Hrishikesh-Acharyya/Ultrasonic-Acoustic-Signal-Acquisition-and-Conditioning-Frontend/Analog_Frontend_Project_Report.pdf

# Ultrasonic Underwater Acoustic Signal Acquisition and Conditioning Frontend

### Comprehensive Design and Simulation Report

### Hrishikesh Acharyya

### February 2026

Abstract

This report details the theoretical design, mathematical modeling, and SPICE validation of an analog frontend engineered to acquire 45 kHz continuous-wave (CW) tone bursts from an Underwater Locator Beacon (ULB). The architecture implements a piezoelectric hydrophone model, a charge amplifier for signal conversion, an 8th-order Butterworth bandpass filter for rigorous out-of-band noise rejection, and an inverting buffer with a kickback filter for ADC interfacing. Transient and frequency response simulations confirm robust harmonic rejection and a highly linear phase response suitable for downstream Digital Signal Processing (DSP) and Time Difference of Arrival (TDOA) localization. Monte Carlo simulations quantify the worst-case error introduced by component tolerances to ensure manufacturing reliability.

## 1 Introduction

Acoustic localization of Underwater Locator Beacons (ULB) by Autonomous Underwater Vehicles (AUVs) requires highly resilient analog frontends capable of isolating specific frequency bands while rejecting severe mechanical noise from thrusters, environmental noise, vibrational noise, and electromagnetic interference (EMI) caused by ESC switching. This project presents a complete analog conditioning pipeline bridging a raw piezoelectric hydrophone output to an Analog-to-Digital Converter (ADC).
A ULB-362 beacon from RJE International was chosen as the reference. The beacons transmit an acoustic signal once every second after activation, converting a CMOS-level square wave into a sinusoidal pulse of duration > 9 ms. Detailed specifications can be derived from the device documentation [1].

## 2 Circuit Architecture

To ensure complete clarity, the entire frontend schematic is divided into three primary functional blocks to process the raw signal from the piezoelectric hydrophone without loss of fidelity.

### 2.1 Sensor Modeling and Charge Amplifier

Initial system parameters are derived from standard ULB and piezoelectric hydrophone specifications. Given an acoustic output of 160.5 dB re 1µPa at 1 meter [1], the acoustic pressure P in Pascals is:
P = 10

160.5
20 | × 10⁻⁶ ≈ 105.9 Pa | (1)

For the hydrophone, using a worst-case receiving sensitivity of −190 dB re 1V/µPa at 1 meter [2], the voltage sensitivity Sv is:

Sv = 10

−190
20 | ≈ 3.16 × 10⁻¹⁰ V/µPa | (2)

Consequently, the estimated unconditioned RMS voltage generated by the sensor at 1 meter is approximately 33.46 mVrms.
To prevent effects of variable cable capacitance, a charge amplifier topology is utilized. The charge amplifier converts accumulated piezoelectric charge directly into a proportional voltage, rendering the system’s gain mathematically independent of cable length. The sensor is modeled electrically as a voltage source in series with a capacitance Cp = 22 nF and a resistance Rp = 287 kΩ as per the topology laid out in [3]. The capacitance and resistance values were calculated by the method shown in [4].

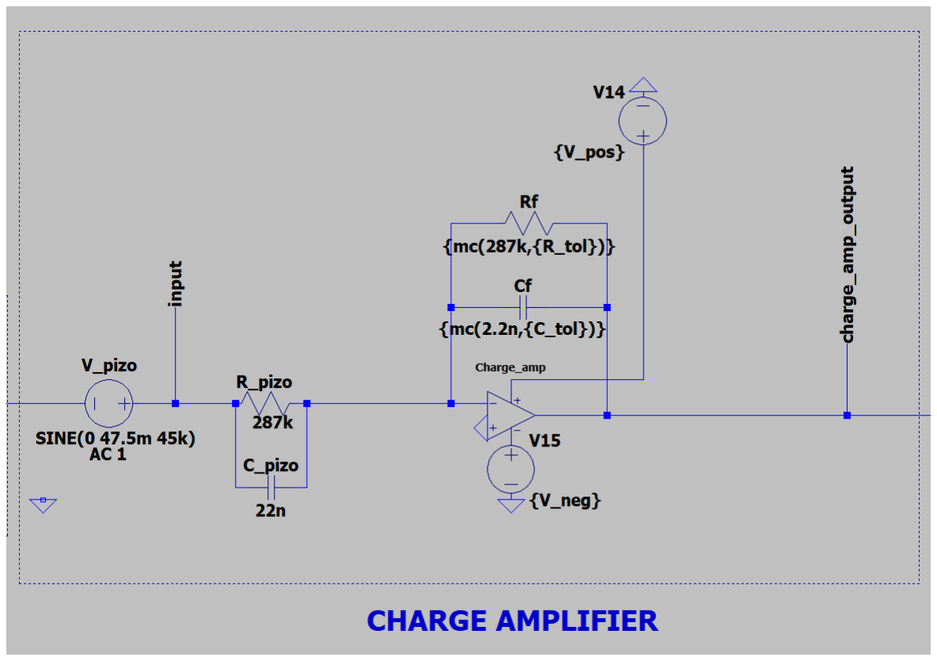
[picture p8: figure]

Figure 1: Stage 1: Hydrophone sensor model feeding into the Charge Amplifier.

The generalized transfer function of the inverting charge amplifier is:

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
1 + sRpCp
1 + sRfCf
(3)

where Zf is the feedback impedance and Zp is the source impedance.
From this complete transfer function, the specific passive component values (Rf and Cf ) are derived by analyzing the circuit at its frequency extremes:

### 1. DC Gain (s → 0): At DC, the capacitive reactance approaches infinity, and the

transfer function simplifies strictly to the ratio of the resistors:

Av(DC) = −

Rf
Rp

(4)

To prevent large DC offsets from saturating the operational amplifier, the DC gain must be restricted. The DC gain is set to unity (|Av| = 1, or 0 dB). Because the hydrophone’s internal resistance is Rp = 287 kΩ, the feedback resistor is explicitly chosen as Rf = 287 kΩ.

### 2. Midband Gain (s → ∞): At the ultrasonic frequencies of interest, s becomes

large, and the sRC terms dominate the numerator and denominator. The transfer function simplifies to the ratio of the capacitances:

Av(midband) ≈ −

Rf
Rp
sRpCp
sRfCf
= −

Cp
Cf

(5)

The sensor capacitance was found as Cp = 22 nF. To achieve a sufficient initial amplification of 20 dB (a voltage gain of 10 V/V) for the estimated 33.46 mVrms input signal, the feedback capacitor is strategically selected as:

Cf =

Cp
10

=

22 nF
10
= 2.2 nF | (6)

### 3. High-Pass Cutoff Frequency: The chosen feedback network (Rf = 287 kΩ, Cf =

2.2 nF) concurrently establishes the dominant pole of the charge amplifier, forming an intrinsic first-order high-pass filter. Care was taken to ensure the cutoff is not too high, otherwise it leaks into the overall filter passband:

fc =

1
2πRfCf

=

1
2π(287 kΩ)(2.2 nF) ≈ 252 Hz | (7)

### 4. High-Frequency Roll-Off and Non-Ideal Behavior: While the ideal transfer

function implies infinite bandwidth, the physical charge amplifier will exhibit an intrinsic low-pass roll-off at high frequencies. This behavior is not dictated by the primary feedback network, but rather by the finite Gain-Bandwidth Product (GBW) of the operational amplifier [3].
The high-frequency −3 dB cutoff of the charge amplifier is determined by the intersection of the op-amp’s open-loop gain roll-off and the circuit’s closed-loop noise gain

(Anoise):

Anoise ≈ 1 +

Cp
Cf

= 1 +

22 nF
2.2 nF
= 11 V/V | (8)

For an operational amplifier with a specified GBW, the intrinsic low-pass pole occurs at:

fLP F ≈

GBW

Anoise

(9)

Assuming a standard high-speed op-amp with a GBW of 100 MHz (as utilized in the SPICE models), the intrinsic low-pass roll-off begins at approximately 9.09 MHz. In the context of the analog frontend, this non-ideal characteristic is highly beneficial, as it acts as an anti-aliasing filter that suppresses extreme high-frequency EMI before the signal reaches the active 8th-order Butterworth stages.

### 2.2 8th-Order Butterworth Bandpass Filter

To achieve rigorous filtering and to isolate the 45 kHz CW tone, an 8th-order Butterworth bandpass filter was synthesized, establishing a passband from 35 kHz to 58 kHz. The architecture cascades two 2nd-order High-Pass Filters (HPF) [5] and two 2nd-order Low-Pass Filters (LPF) [6] utilizing Multiple Feedback (MFB) topologies [7].

### 2.2.1 Computational Synthesis of Filter Parameters

To ensure mathematical rigour, the derivation of the exact component values for the MFB cascaded network was performed using a custom Python computational script. Rather than calculating continuous theoretical values and rounding them—which often leads to severe center-frequency drift in high-Q stages—the algorithm operates by anchoring the math to discrete, commercially available E6 series capacitors.
The algorithm executes the following sequence to bridge the theoretical MFB transfer functions with physical hardware constraints:
1. E-Series Grid Search: The script iteratively sweeps through an array of standard E6 series capacitors (100 pF to 10 nF) to use as the foundational variables.
2. Gain and Topology Constraints: The script enforces a DC gain of -1 by setting C1 = C3 in HPF stages and R1 = R3 in LPF stages.
3. Mathematical Derivation: For the LPF, the script evaluates the discriminant (b

2 − 4ac) of the MFB design equations, explicitly rejecting capacitor combinations where C1 < 8Q²C2 to prevent physically impossible, imaginary resistor solutions. It then solves the quadratic roots to find R1. For the HPF, algebraic derivations directly yield R1 and R2. Equations were derived from [5] and [6].

4. Practical Boundary Filtering: The final combinations are rigorously constrained; the algorithm only outputs configurations where the resulting resistors fall within a physically practical and noise-minimized manufacturing range of 1 kΩ to 1 MΩ.

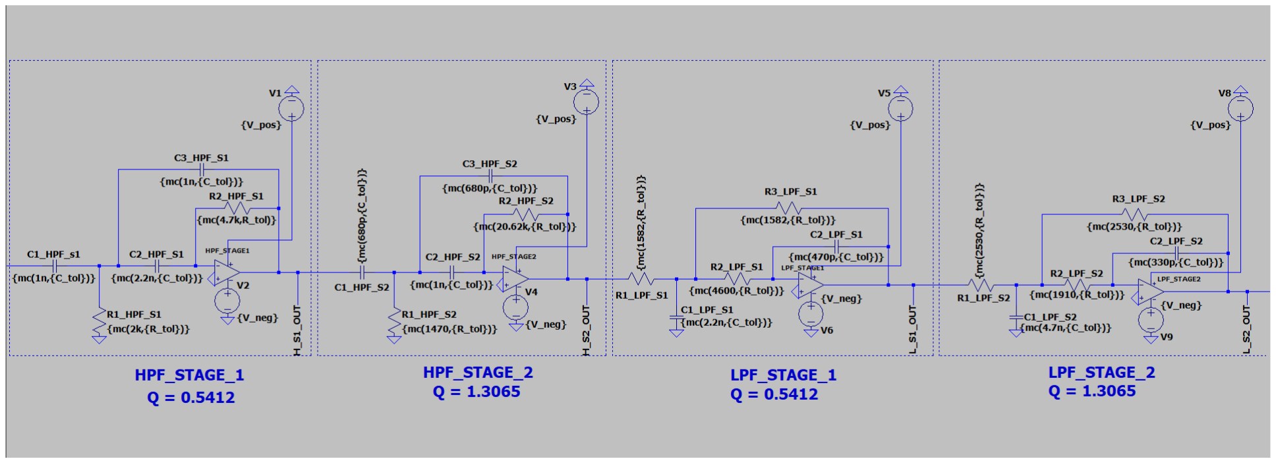
[picture p9: figure]

Figure 2: Stage 2: Cascaded HPF and LPF stages forming the 8th-order Butterworth response.

The standard 4th-order Butterworth polynomial dictates stage-specific quality factors of Q1 = 0.5412 and Q2 = 1.3065 [8]. The component values were chosen from the list provided by the script and tweaked according to availability and suitability.

- High-Pass Filter Stages (fc = 35 kHz):

– Stage 1 (Q = 0.5412): C1,3 = 1 nF, C2 = 2.2 nF, R1 = 2 kΩ, R2 = 4.7 kΩ.

– Stage 2 (Q = 1.3065): C1,3 = 680 pF, C2 = 1 nF, R1 = 1470 Ω, R2 = 20.62 kΩ.

- Low-Pass Filter Stages (fc = 58 kHz):

– Stage 1 (Q = 0.5412): C1 = 2.2 nF, C2 = 470 pF, R1,3 = 1582 Ω, R2 = 4.6 kΩ.

– Stage 2 (Q = 1.3065): C1 = 4.7 nF, C2 = 330 pF, R1,3 = 2.53 kΩ, R2 = 1.91 kΩ.

### 2.3 Output Stage: Inverting Buffer and Feedthrough Protection

Because the combined charge amplifier and Butterworth stages apply a net 180-degree phase shift, an inverting buffer is implemented at the output to restore the signal to be strictly in phase with the incoming acoustic wave. The non-inverting terminal is biased to 1.65 V to perfectly center the AC signal within a unipolar 0 − 3.3V ADC window.


Figure 3: Stage 3: Inverting buffer with DC offset and ADC kickback filter.

To protect against high-frequency ADC sampling transients (kickback) and EMI aliasing into the passband, a passive RC feedthrough filter [9] is implemented at the final

output node:

ffeedthrough =

1
2πRf tCf t

=

1
2π(100Ω)(1.5 nF) ≈ 1.06 MHz | (10)

## 3 Simulation Verification

### 3.1 Charge Amplifier Broadband Response

The initial conditioning stage uses a charge-amplifier topology to convert the highimpedance piezoelectric stimulus into a low-impedance voltage signal. As shown in Figure 4, the stage provides a stable, flat-band gain across the ultrasonic spectrum of interest.

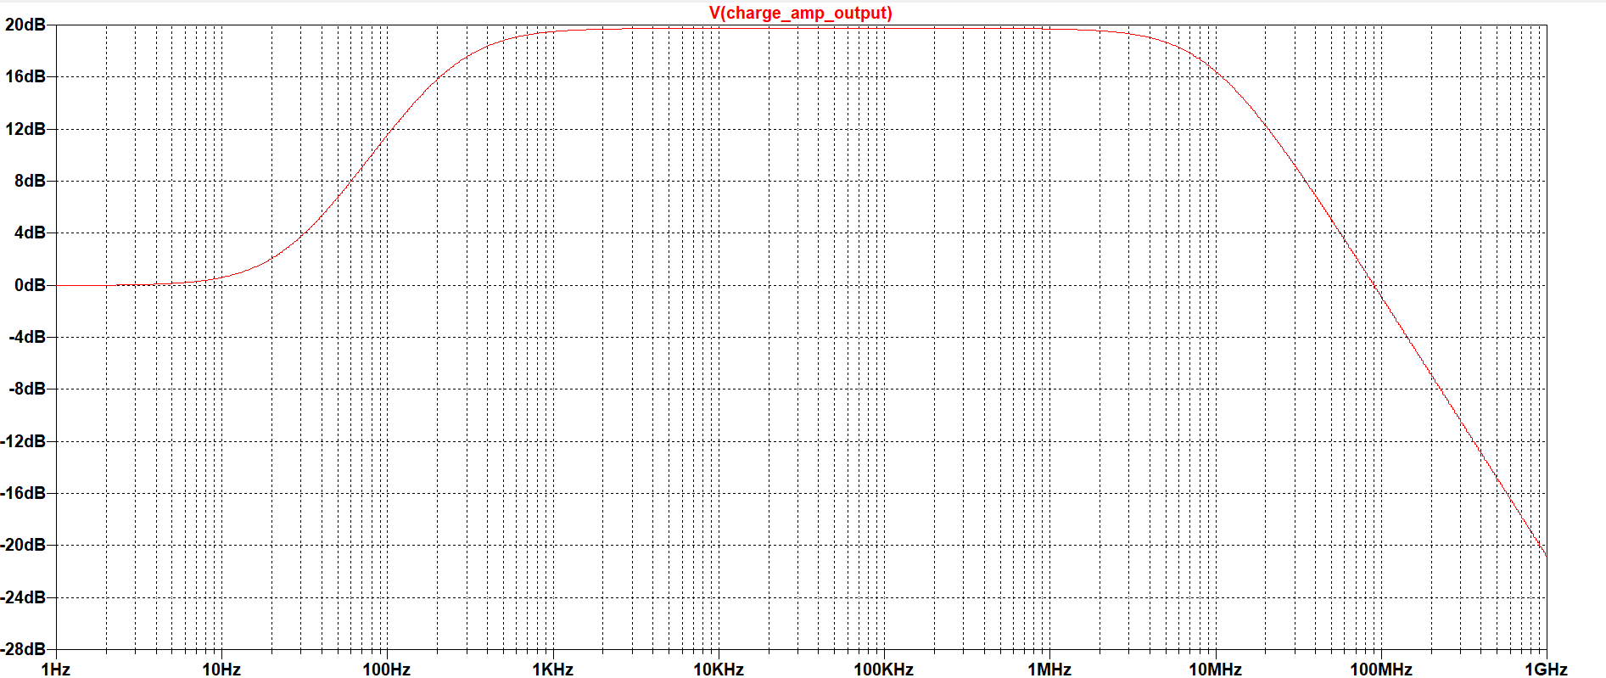
[picture p10: figure]

Figure 4: Bode plot of the Charge Amplifier stage (V(charge amp output)), demonstrating a stable 19.74 dB gain.

The simulated gain of 19.74 dB aligns with the theoretical target of 20 dB (Cp/Cf = 10), with a negligible 1.28% variance attributed to tolerance error.

Table 1: Charge Amplifier Simulation Results

Parameter | Theoretical Simulated |% Error|
Midband Gain | 20.00 dB | 19.744 dB | 1.28%
Upper 3dB cutoff | 9.09 MHz | 9.33 MHz | 2.64%
Lower 3dB cutoff | 252.06 Hz | 242.84 Hz | 3.65%

### 3.2 Overall System Response: 8th-Order MFB Filter

The complete signal chain incorporates a cascaded 8th-order Butterworth filter to isolate the target 45 kHz CW beacon. Figure 5 illustrates the total system response, characterized by steep roll-off rates exceeding -80 dB/decade in the stopbands.


Figure 5: Overall system frequency response (V(output)) showing the 35–58 kHz passband.

The measurement of the system-wide gain at 18.45 dB is accounted for by component tolerance errors. The -3 dB cutoff frequencies were programmatically extracted to confirm passband compliance.

Table 2: Integrated System AC Parameters

Parameter | Target | Simulated |% Error|
Peak System Gain | 20.00 dB | 18.45 dB | 7.75%
Lower Cutoff (fL) | 35.00 kHz | 32.06 kHz | 8.40%
Upper Cutoff (fH) 58.00 kHz | 60.24 kHz | 3.86%
-3 dB Bandwidth | 23.00 kHz | 28.18 kHz | 22.5%

### 3.3 Steady State Transient Analysis and Phase Integrity

Transient simulations confirm the phase inversion of the charge amplifier (Figure 6) and the successful rectification by the final buffer stage (Figure 7). The output waveform is strictly in phase and sits perfectly on the 1.65 V DC bias. The measured output amplitude of 788.7 mVp-p reflects a minor, expected attenuation from the theoretical 950 mV due to cumulative passive component tolerances (Figure 8).

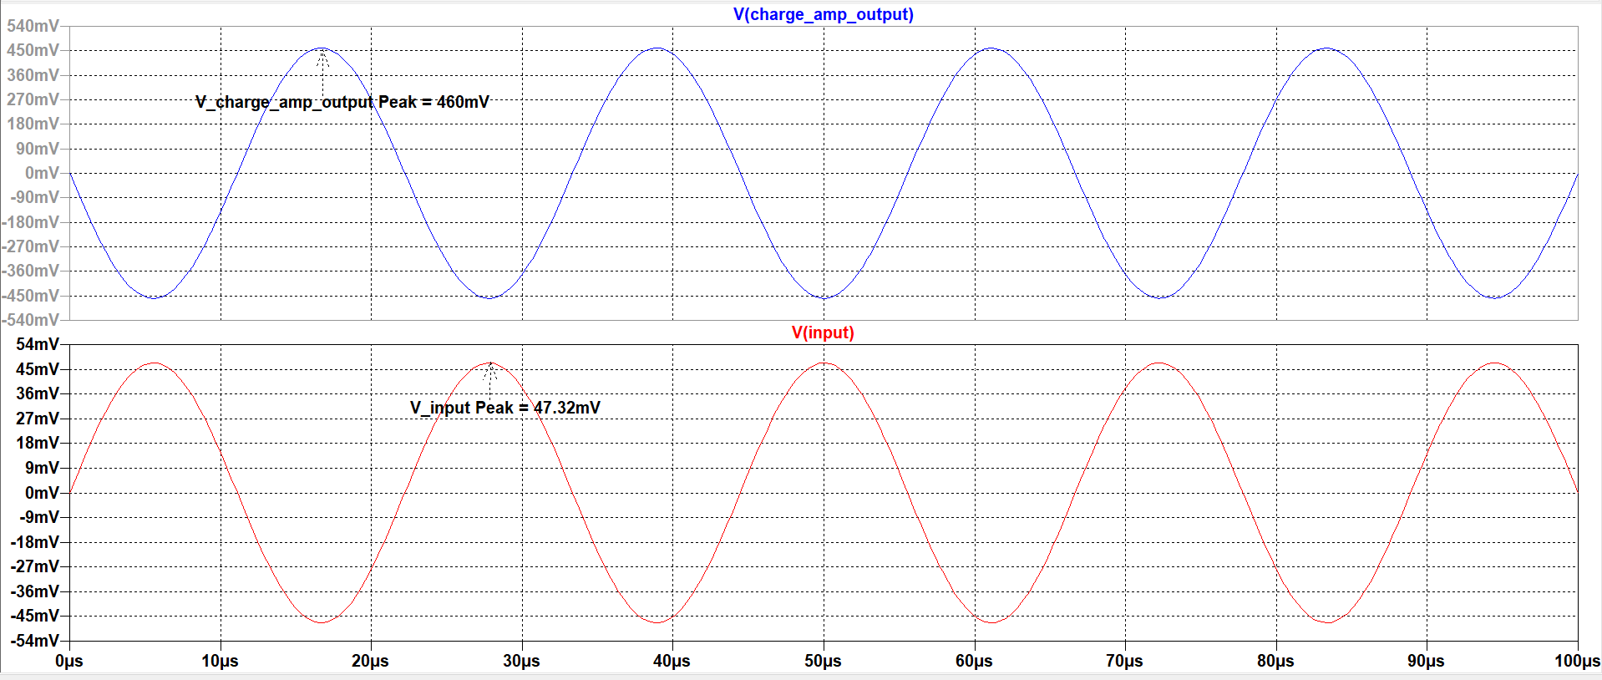
[picture p11: figure]

Figure 6: Charge amp output exhibiting theoretical 180◦ phase inversion: Input(bottom) vs Charge amplifier output(top)

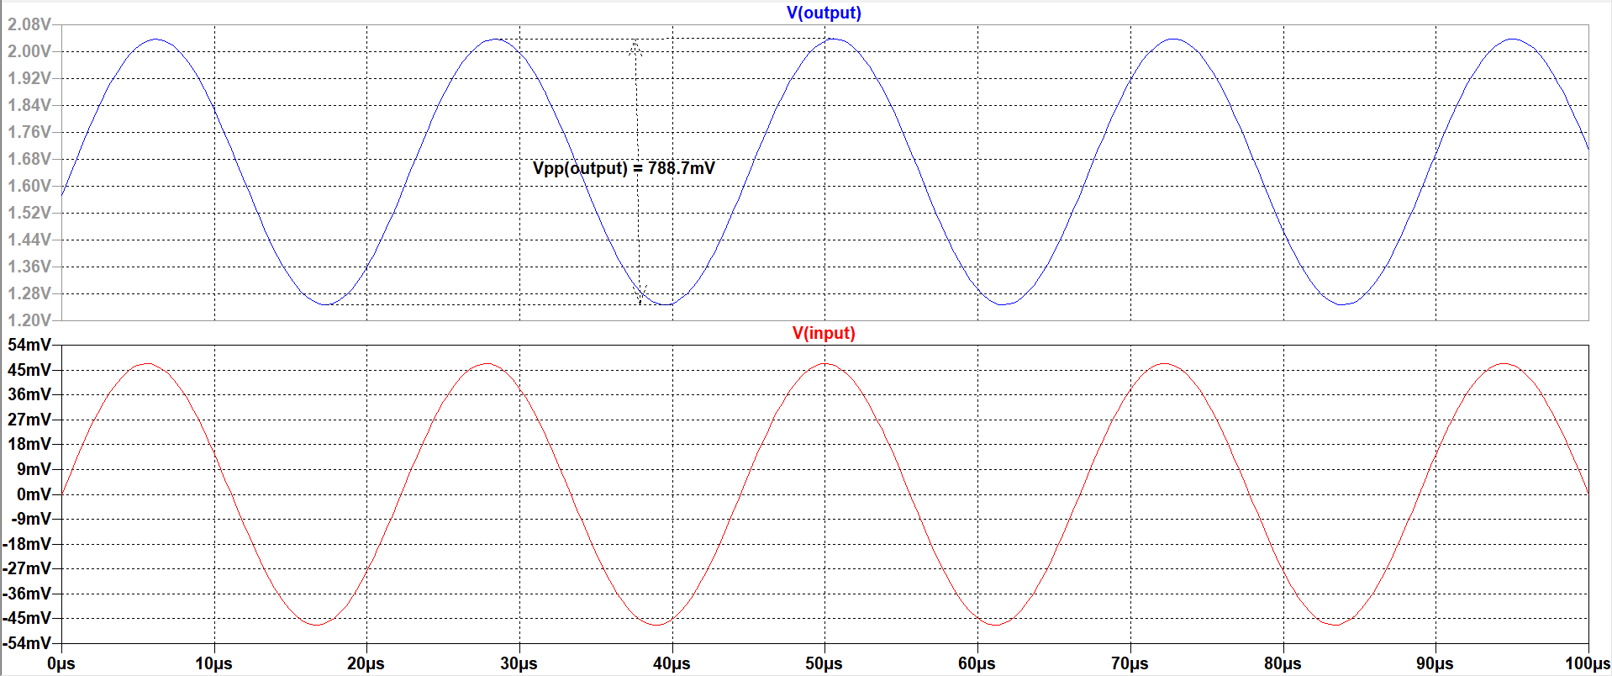
[picture p12: figure]

Figure 7: Final conditioned output: Inphase and DC-shifted to 1.65 V: Input(bottom) vs Output (top)

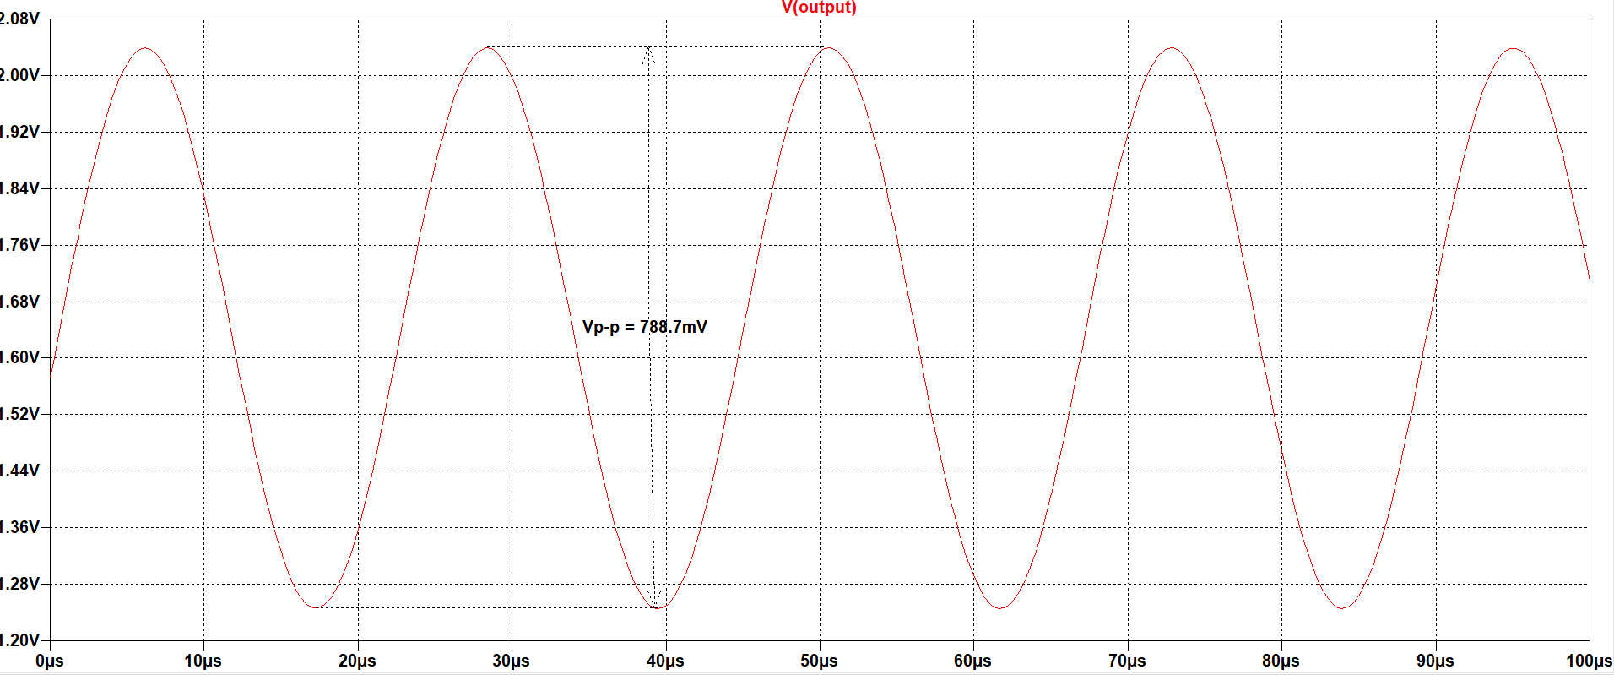
[picture p13: figure]

Figure 8: Amplitude measurement of 788.7 mVp-p.

### 3.4 Harmonic Rejection

To rigorously test the 8th-order roll-off, severe harmonics at 90 kHz and 135 kHz were injected into the input stimulus. As illustrated in Figure 9, the system aggressively strips the harmonics, yielding a pristine fundamental tone ready for thresholding.


Figure 9: Robust harmonic rejection: Polluted input (bottom) vs. Filtered output (top).

### 3.5 Monte Carlo Simulation

To understand the effect of component tolerances on the viability of the frontend for Time Difference of Arrival (TDOA) work, and to quantify the worst-case channel-tochannel error, a Monte Carlo simulation was executed. The analysis utilized a Gaussian distribution over 10000 iterative runs to model the natural manufacturing drift of the specified passive components. The resulting phase spread is detailed in Figure 10.


Figure 10: Iterations vs. phase angle at 45 kHz. The spread is 27 degrees.

## 4 System Specifications Summary

To synthesize the design constraints and simulation environment utilized throughout this study, the primary operational parameters for the complete analog signal chain are consolidated in Table 3. This serves as the foundational design envelope for future hardware fabrication.

Table 3: Hardware and Simulation Design Envelope

System Parameter | Specification / Constraint
Target Center Frequency (fc) | 45 ± 1 kHz (CW Tone Burst)
Passband Range | 35 kHz − −58 kHz
Power Supply (Vcc/Vee) | ±5 V (Dual Supply)
Output DC Bias (Vref ) | +1.65 V (Unipolar ADC Centering)
Active Components Required | 6x Operational Amplifiers
Op-Amp Specifications (MFB Rule) [5, 6] GBW ≥ 100 × Noise Gain × fmax, High SR
Passive Component Constraints | Resistors: 1%, Capacitors: 5%
Statistical Validation | 10000-Run Monte Carlo (Gaussian Distribution)

## 5 Consolidated Bill of Materials (BOM)

The following table reflects a consolidated manufacturing Bill of Materials derived from the SPICE netlist. Components are grouped by value to reflect standard procurement and assembly practices. Operational amplifiers must strictly meet the high-speed specifications outlined in Table 3 to prevent slew-induced distortion. The component values are given as produced by the netlist and left for the designer to break down into procurable values. The tolerance values are chosen such that the overall cost of procurement is nominal.

Table 4: Consolidated Manufacturing BOM

Qty Value | Description / Tolerance Reference Designators

Integrated Circuits

6 | High-Speed Op-Amp, GBW ≥ 10MHz | Charge amp, | HPF STAGE 1,
| | | HPF STAGE 2, | LPF STAGE 1,
LPF STAGE 2, INV BUFFER

Capacitors (5% Tolerance, C0G/NP0 Dielectric)

1 | 330 pF | Ceramic Capacitor | C2 LPF S2
1 | 470 pF | Ceramic Capacitor | C2 LPF S1
2 | 680 pF | Ceramic Capacitor | C1 HPF S2, C3 HPF S2
3 | 1 nF | Ceramic Capacitor | C1 HPF S1, | C3 HPF S1,
| | | C2 HPF S2
1 | 1.5 nF | Ceramic Capacitor | C FEEDTHROUGH
3 | 2.2 nF | Ceramic Capacitor | C1 LPF S1, C2 HPF S1, Cf
1 | 4.7 nF | Ceramic Capacitor | C1 LPF S2
1 | 100 nF | Ceramic Capacitor | C DC COUPLING
1 | 4.7 µF | Ceramic Capacitor | C NOISE REMOVAL

Resistors (1% Tolerance, Metal Film)

1 | 100 Ω | Precision Resistor | R FEEDTHROUGH
1 | 1.47 kΩ | Precision Resistor | R1 HPF S2
2 | 1.58 kΩ | Precision Resistor | R1 LPF S1, R3 LPF S1
1 | 1.91 kΩ | Precision Resistor | R2 LPF S2
1 | 2 kΩ | Precision Resistor | R1 HPF S1
2 | 2.53 kΩ | Precision Resistor | R1 LPF S2, R3 LPF S2
1 | 4.6 kΩ | Precision Resistor | R2 LPF S1
1 | 4.7 kΩ | Precision Resistor | R2 HPF S1
2 | 10 kΩ | Precision Resistor | R1, R2
1 | 20.62 kΩ | Precision Resistor | R2 HPF S2
2 | 100 kΩ | Precision Resistor | R BIAS 1, R BIAS 2
1 | 287 kΩ | Precision Resistor | Rf

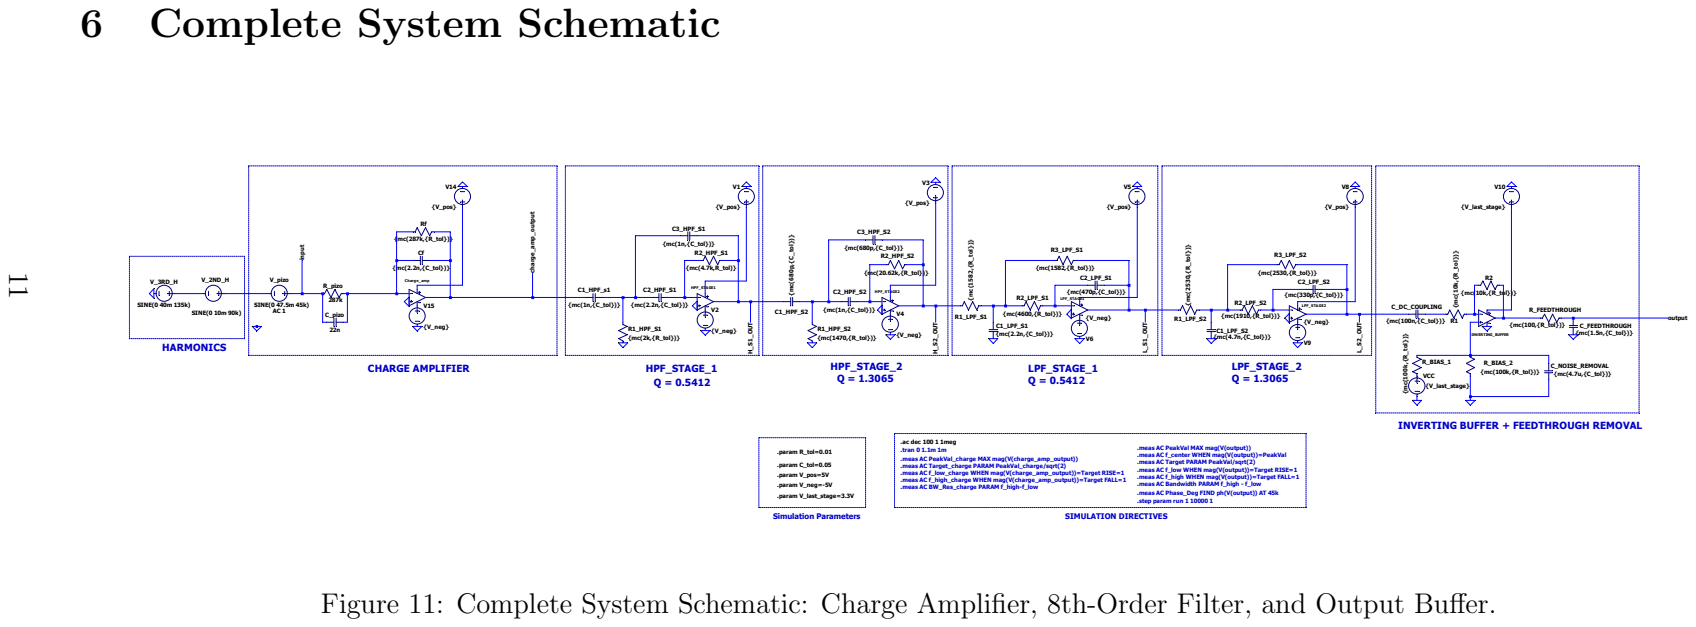
[picture p14: page 11]
HPF_STAGE1 C1_HPF_s1; {mc(1n,{C_tol})}; {mc(2k,{R_tol})}; R1_HPF_S1; C2_HPF_S1; {mc(2.2n,{C_tol})}; R2_HPF_S1; {mc(4.7k,R_tol)}; C3_HPF_S1; {V_pos}; {V_neg}; HPF_STAGE2; C1_HPF_S2 {mc⁽680p,{C_tol}⁾}; {mc(1470,{R_tol})}; R1_HPF_S2; C2_HPF_S2; R2_HPF_S2; {mc(20.62k,{R_tol})}; C3_HPF_S2; {mc(680p,{C_tol})}; LPF_STAGE1; R1_LPF_S1 {mc⁽1582,{R_tol}⁾}; R2_LPF_S1; {mc(4600,{R_tol})}; R3_LPF_S1; {mc(1582,{R_tol})}; C1_LPF_S1; C2_LPF_S1; {mc(470p,{C_tol})}; LPF_STAGE2; R1_LPF_S2 {mc⁽2530,{R_tol}⁾}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

6 Complete System Schematic

INVERTING BUFFER + FEEDTHROUGH REMOVAL

.ac dec 100 1 1meg
.tran 0 1.1m 1m
.meas AC PeakVal_charge MAX mag(V(charge_amp_output))
.meas AC Target_charge PARAM PeakVal_charge/sqrt(2)
.meas AC f_low_charge WHEN mag(V(charge_amp_output))=Target RISE=1
.meas AC f_high_charge WHEN mag(V(charge_amp_output))=Target FALL=1
.meas AC BW_Res_charge PARAM f_high-f_low

.meas AC PeakVal MAX mag(V(output))
.meas AC f_center WHEN mag(V(output))=PeakVal
.meas AC Target PARAM PeakVal/sqrt(2)
.meas AC f_low WHEN mag(V(output))=Target RISE=1
.meas AC f_high WHEN mag(V(output))=Target FALL=1
.meas AC Bandwidth PARAM f_high - f_low
.meas AC Phase_Deg FIND ph(V(output)) AT 45k
.step param run 1 10000 1

Figure 11: Complete System Schematic: Charge Amplifier, 8th-Order Filter, and Output Buffer.

## 7 Conclusion

The analog frontend successfully conditions 45 kHz acoustic signals while providing rigorous harmonic rejection and unwanted noise removal. Monte Carlo analysis confirmed a worst-case phase drift of 27◦ between channels, which is passable for short-range passive acoustic localization.

### 7.1 Future Work

- Group Delay Optimization: Address the observed 9µs group delay to enhance real-time TDOA performance. This can be done by using Bessel-Butterworth hybrid filters.
- Dynamic Gain Control: Integrate a Programmable Gain Amplifier (PGA) to maintain signal integrity as pinger distance varies.
- Hardware Prototyping: Transition from SPICE validation to PCB fabrication to assess real-world SNR.
- Component Selection: Select components with tighter tolerances or investigate Leapfrog topologies to further minimize the effect of component tolerances.

## References

[1] ULB-362 Series Underwater Locator Beacon User’s Manual, RJE International, Inc., May 2015. [Online]. Available: https://www.rjeint.com/wp-content/uploads/2017/01/ULB-362-ULB-362PL-Manual.pdf (https://www.rjeint.com/wp-content/uploads/2017/01/ULB-362-ULB-362PL-Manual.pdf)
[2] H1c Hydrophone User’s Guide, Aquarian Audio Products. [Online]. Available: https://www.aquarianaudio.com/AqAudDocs/H1c%20manual.pdf
[3] J. Karki, “Signal conditioning piezoelectric sensors,” Texas Instruments, Application Report SLOA033A, September 2000. [Online]. Available: https://www.ti.com/lit/an/sloa033a/sloa033a.pdf (https://www.ti.com/lit/an/sloa033a/sloa033a.pdf)
[4] A. Shaw, A. Kumari, H. P. S. Kumar, S. K. Kar, A. Dutta, and S. Kundu, “Design considerations of signal acquisition circuit development for piezoelectric pressure sensor,” in 2024 IEEE 21st India Council International Conference (INDICON). IEEE, 2024, pp. 1–5.
[5] “Single-supply, 2nd-order, multiple feedback high-pass filter circuit,” Texas Instruments, Analog Engineer’s Circuit Cookbook: Amplifiers, 2022. [Online]. Available: https://www.ti.com/lit/an/sboa230/sboa230.pdf?ts=1772224373468&refurl=https%253A%252F%252Fwww.google.com%252F (https://www.ti.com/lit/an/sboa230/sboa230.pdf?ts=1772224373468)
[6] “Single-supply, 2nd-order, multiple feedback low-pass filter circuit,” Texas Instruments, Analog Engineer’s Circuit Cookbook: Amplifiers, 2022. [Online]. Available: https://www.ti.com/lit/an/sboa231/sboa231.pdf?ts=1772224342111&refurl=https%253A%252F%252Fwww.google.com%252F (https://www.ti.com/lit/an/sboa231/sboa231.pdf?ts=1772224342111)

[7] M. Steffes, “Design methodology for mfb filters in adc interface,” Texas Instruments, Application Report SBOA114, February 2006. [Online]. Available: https://www.ti.com/lit/an/sboa114/sboa114.pdf?ts=1772175960600
[8] M. E. Van Valkenburg, Analog Filter Design. New York: Oxford University Press, 1982.
[9] J. Karki, “Active low-pass filter design,” Texas Instruments, Application Note, 2023. [Online]. Available: https://www.ti.com/lit/an/sloa049d/sloa049d.pdf?ts=1772187 304348 (https://www.ti.com/lit/an/sloa049d/sloa049d.pdf?ts=1772187304348)
