Hrishikesh-Acharyya/Ultrasonic-Acoustic-Signal-Acquisition-and-Conditioning-Frontend/adc_frontend.asc

C1_HPF_s1: cap; {mc(1n,{C_tol})}
C1_HPF_S2: cap; {mc(680p,{C_tol})}
C1_LPF_S1: cap; {mc(2.2n,{C_tol})}
C1_LPF_S2: cap; {mc(4.7n,{C_tol})}
C2_HPF_S1: cap; {mc(2.2n,{C_tol})}
C2_HPF_S2: cap; {mc(1n,{C_tol})}
C2_LPF_S1: cap; {mc(470p,{C_tol})}
C2_LPF_S2: cap; {mc(330p,{C_tol})}
C3_HPF_S1: cap; {mc(1n,{C_tol})}
C3_HPF_S2: cap; {mc(680p,{C_tol})}
C_DC_COUPLING: cap; {mc(100n,{C_tol})}
C_FEEDTHROUGH: cap; {mc(1.5n,{C_tol})}
C_NOISE_REMOVAL: cap; {mc(4.7u,{C_tol})}
C_pizo: cap; 22n
Cf: cap; {mc(2.2n,{C_tol})}
Charge_amp: UniversalOpAmp; Avol=1Meg GBW=100meg Vos=0
HPF_STAGE1: UniversalOpAmp; Avol=1Meg GBW=100meg Vos=0
HPF_STAGE2: UniversalOpAmp; Avol=1Meg GBW=100meg Vos=0
INVERTING_BUFFER: UniversalOpAmp; Avol=1Meg GBW=100meg Vos=0
LPF_STAGE1: UniversalOpAmp; Avol=1Meg GBW=100meg Vos=0
LPF_STAGE2: UniversalOpAmp; Avol=1Meg GBW=100meg Vos=0
R1: res; {mc(10k,{R_tol})}
R1_HPF_S1: res; {mc(2k,{R_tol})}; tol=1
R1_HPF_S2: res; {mc(1470,{R_tol})}; tol=1
R1_LPF_S1: res; {mc(1582,{R_tol})}; tol=1
R1_LPF_S2: res; {mc(2530,{R_tol})}; tol=1
R2: res; {mc(10k,{R_tol})}
R2_HPF_S1: res; {mc(4.7k,R_tol)}; tol=1
R2_HPF_S2: res; {mc(20.62k,{R_tol})}; tol=1
R2_LPF_S1: res; {mc(4600,{R_tol})}; tol=1
R2_LPF_S2: res; {mc(1910,{R_tol})}; tol=1
R3_LPF_S1: res; {mc(1582,{R_tol})}; tol=1
R3_LPF_S2: res; {mc(2530,{R_tol})}; tol=1
R_BIAS_1: res; {mc(100k,{R_tol})}; tol=1
R_BIAS_2: res; {mc(100k,{R_tol})}; tol=1
R_FEEDTHROUGH: res; {mc(100,{R_tol})}
R_pizo: res; 287k
Rf: res; {mc(287k,{R_tol})}
V1: voltage; {V_pos}
V2: voltage; {V_neg}
V3: voltage; {V_pos}
V4: voltage; {V_neg}
V5: voltage; {V_pos}
V6: voltage; {V_neg}
V8: voltage; {V_pos}
V9: voltage; {V_neg}
V10: voltage; {V_last_stage}
V14: voltage; {V_pos}
V15: voltage; {V_neg}
V_2ND_H: voltage; SINE(0 10m 90k)
V_3RD_H: voltage; SINE(0 40m 135k)
V_pizo: voltage; SINE(0 47.5m 45k); AC 1
VCC: voltage; {V_last_stage}
Named nets: 0, charge_amp_output, output, input, H_S1_OUT, H_S2_OUT, L_S1_OUT, L_S2_OUT
.ac dec 100 30k 75k
.tran 0 1.1m 1m
CHARGE AMPLIFIER
HPF_STAGE_1
Q = 0.5412
HPF_STAGE_2
Q = 1.3065
LPF_STAGE_1
Q = 0.5412
LPF_STAGE_2
Q = 1.3065
INVERTING BUFFER + FEEDTHROUGH REMOVAL
SIMULATION DIRECTIVES
HARMONICS
.step param run 1 100 1
.meas AC Vout_complex FIND V(output) AT 45k
.param R_tol=0.01
.param C_tol=0.05
.param V_pos=5V
.param V_neg=-5V
.param V_last_stage=3.3V
Simulation Parameters
